somhi/AmstradXTPS2/README.md

# PS/2 TO AMSTRAD XT KEYBOARD PROTOCOL CONVERTER

This is an Arduino board based project to convert PS2 keyboard protocol to Amstrad XT protocol. 

Amstrad had its own keyboard protocol different from the IBM PC XT one.   This protocol appears to be the same as the one used by later Amstrad XT keyboards up to the PC3086, so in theory this converter should be compatible with Amstrad PC1512 / PC1640 / PC2086 / PC3086.

**Please note that actually It has only been tested with Amstrad PC1512.**

Code is based and adapted from PS/2 to XT keyboard converter  <https://github.com/kesrut/pcxtkbd>

Please add https://github.com/techpaul/PS2KeyAdvanced Arduino library to compile.

I used an Arduino nano (5V) board. Any other Arduino based board can be used as far as it has 5 V logic levels as keyboard power supply and signals work at 5 V.

<u>Have a look also at my personal log of the process I made to get my Amstrad PC1512 working</u> https://github.com/somhi/Amstrad-PC1512.

### Schematic and pinouts

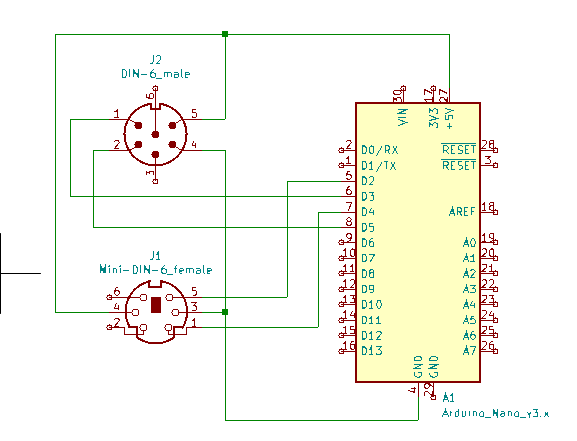
[picture p1: images/schematic.png]
schematic


**NOTE1: BEFORE CONNECTING THE ADAPTER TO YOUR AMSTRAD I STRONGLY ADVICE YOU TO CHECK WITH A TESTER POWER PINS FROM MOTHERBOARD AND DOUBLECHECK WHERE THOSE PINS ARE GOING TO BE CONNECTED TO YOUR ADAPTER**

**NOTE2: IS BETTER ALSO IF YOU CAN POWER SUPPLY YOUR ADAPTER FIRST WITH A DIRECT POWER SUPPLY WITH CURRENT LIMITATION TO CHECK THAT THE ARDUINO UNO BOARD WILL NOT START A FIRE IF THE POWER IS NOT CONNECTED AS IT SHOULD BE.**

A Female PS2 connector (Mini-DIN-6) is needed to connect to the male connector of PS2 keyboard.

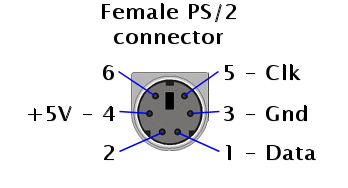
[picture p2: images/PS2-female.png]
PS2-female


A Male DIN 6 connector is needed to connect to the female connector of the Amstrad motherboard.

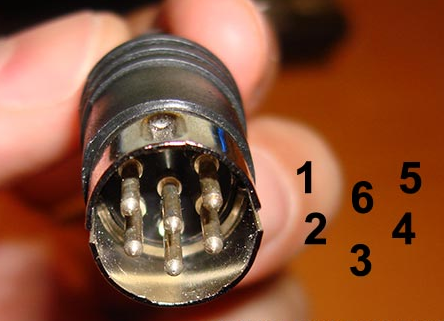
[picture p3: images/din6-male.png]
din6-male


Follows pinout of the DIN-6 female connector of the Amstrad motherboard:

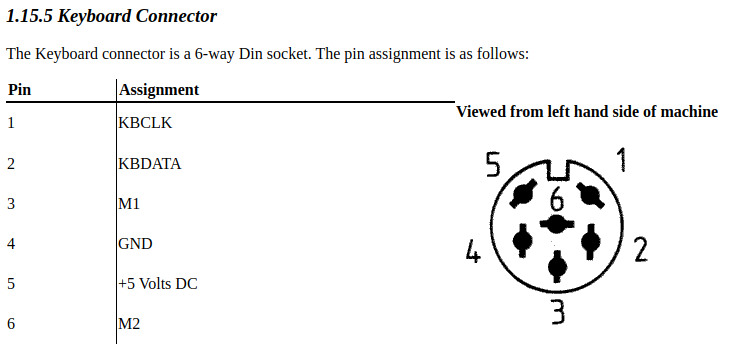
[picture p4: images/6way-PC1512.png]


Pins M1 and M2 are not used for keyboard.

More information and the schematic from where I based my project, can be found at http://www.ccgcpu.com/2019/02/14/the-xt-part-4-adapting-a-modernish-keyboard/, where describes a PS2 to XT protocol converter.   **Please be careful** as IMHO the schematics shown in this article are a bit confusing, as I end up connecting power in the wrong way, so as a result one Arduino nano was fried and  the PS2 keyboard is broken.

I first built a PS2 Mini-Din-6 female to DIN-5 male IBM XT protocol converter. As I fried my second Nano board, I decided to use the same converter and make it compatible also with the Amstrad using another adapter to connect the wires. As I did not have the 6-way Din Amstrad PC1512 keyboard connector I ended up soldering the keyboard wires directly to the motherboard. **I apologize if some of you got a heart attack after seeing this.**

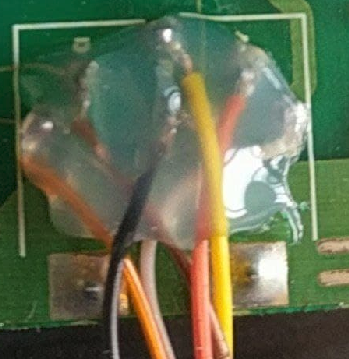
[picture p5: images/mb-soldered.png]
mb-soldered


### Bill of materials

* Arduino Nano 5V
* DIN5 Male to Mini DIN6 PS/2 Female keyboard adapter cable (From where I get the mini-DIN-6 female, and also the DIN5 to build the converter to IBM XT protocol )
* DIN6 Male connector [ordered this but not tested yet](https://es.rs-online.com/web/p/conectores-din/0776280/)
* Wires and thermo-retractil shrinking tubing 

### Protocol adaptation

In order to adapt the protocol I found the following documentation regarding the PC1512 protocol:

* Amstrad PC1512 protocol <https://www.seasip.info/AmstradXT/pc1512kbd.html>
* Keyboard signals timing graph <http://www.kbdbabel.org/signaling/index.html>

These are the signals graphs when the key "k" is pressed: 

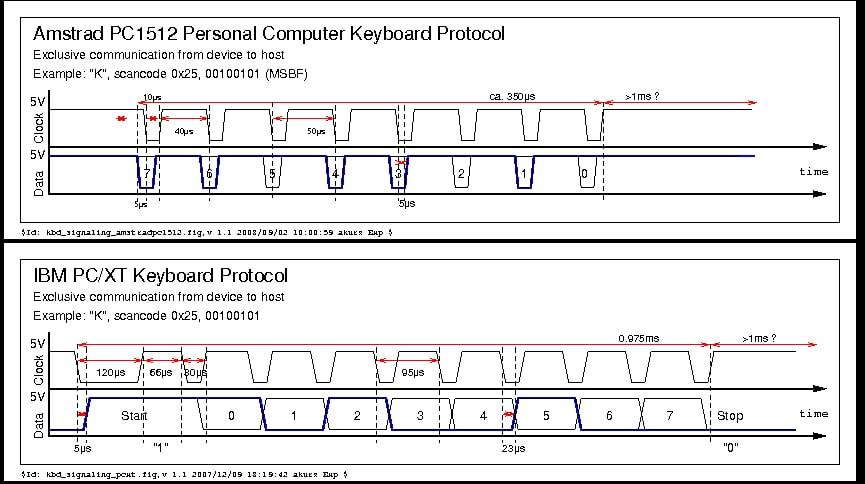
[picture p6: images/keyboard-timing-diagrams.jpg]
keyboard-timing-diagrams


When I had the XT protocol converter running well, I adapted the Arduino code to look like the PC1512 graph with the help of a logic analyzer.

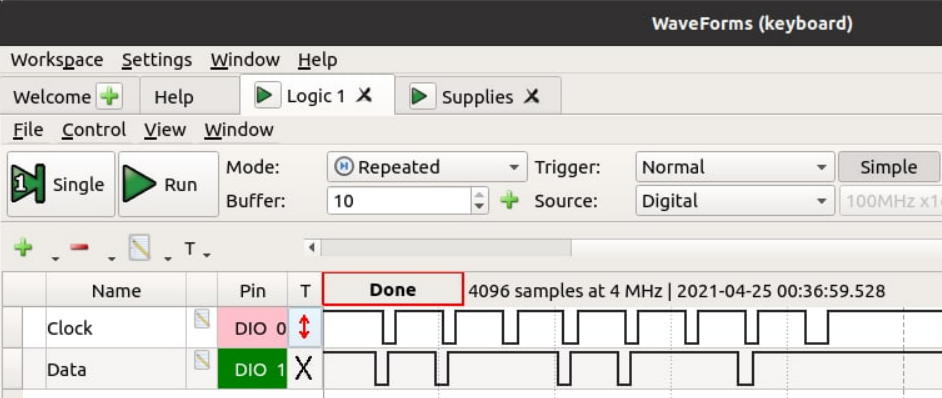
[picture p7: images/logic-analyzer.png]
logic-analyzer


### Final assembly pictures of the adapter:

here attached with a logic analyzer

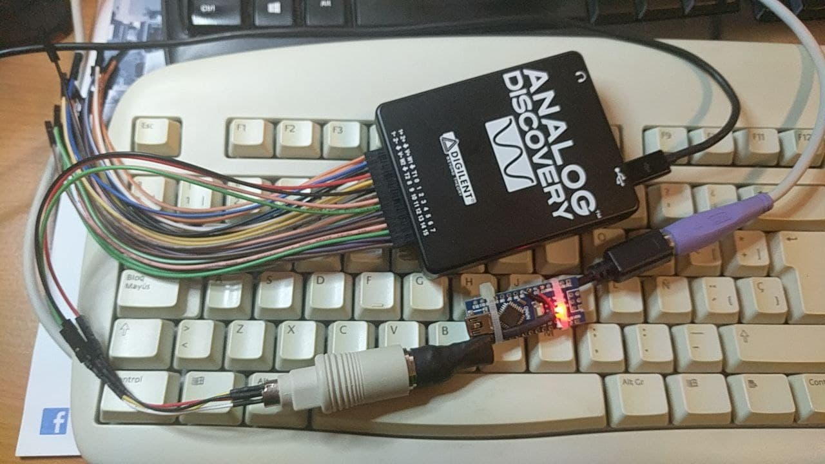
[picture p8: images/converter.jpg]
converter


and here full assembly connected to my [Amstrad PC1512](https://github.com/somhi/Amstrad-PC1512) motherboard:

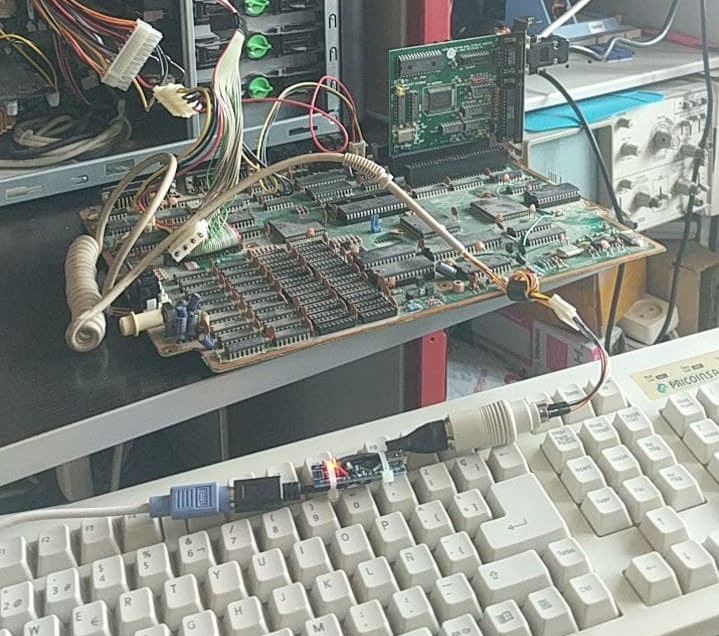
[picture p9: images/assembly.jpg]
assembly
